oo-eric/guitar-build/output/STAGE_3B.md

=== ADC Test ===
Reading A0 every 500ms: avg | min | max | spread
Stage 1 (nothing): floating random values
Stage 2 (bias only): stable ~2048, spread < 50
Stage 3 (full circuit): ~2048 idle, spread grows on pluck
---
avg: 2043 | min: 2043 | max: 2043 | spread: 0
avg: 2052 | min: 2035 | max: 2069 | spread: 34
avg: 2051 | min: 2033 | max: 2070 | spread: 37
avg: 2051 | min: 2032 | max: 2070 | spread: 38
avg: 2052 | min: 2033 | max: 2071 | spread: 38
avg: 2049 | min: 2030 | max: 2068 | spread: 38
avg: 2052 | min: 2033 | max: 2071 | spread: 38
avg: 2049 | min: 2030 | max: 2068 | spread: 38
avg: 2052 | min: 2034 | max: 2070 | spread: 36
