oo-eric/guitar-build/docs/stompbox/pin_map.md

# Teensy 4.0 pin map — single source of truth

Every pin the stomp box uses. **Check here before assigning anything new** —
this conversation has already produced one collision (pin 1) that would have
been silent until the display and MIDI were tested together.

## Physical layout

Teensy 4.0 has 14 pins per side. USB at the top.

```
              ___USB___
      GND  --|         |--  Vin      <- 5V from the power section
        0  --|         |--  GND
        1  --|  ! ! !  |--  3.3V     -> preamp board
        2  --|         |--  23
        3  --|         |--  22
        4  --|         |--  21
        5  --|         |--  20       <- flanks the analog block, keep clear
        6  --|         |--  19 / A5
        7  --|         |--  18 / A4
        8  --|         |--  17 / A3
        9  --|         |--  16 / A2
       10  --|         |--  15 / A1
       11  --|         |--  14 / A0
       12  --|_________|--  13       <- flanks the analog block. SPI0 SCK
```

**The rule:** analog lives on the right column. Keep switching digital signals
on the left column. Pins **13** and **20** flank the analog block and are the
two most dangerous places to put anything that toggles.

## Assignments

| Pin | Use | Notes |
| ----- | --- | --- |
| 0 | **74HC595 latch (RCLK)**  | Drives all four LED halos. Data/clock share SPI0 |
| **1** | **RESERVED — do not use** | Collision: Serial1 TX _and_ SPI1 MISO. See below |
| 2 | Footswitch — PANIC | Momentary, Bounce2 |
| 3 | Footswitch — MODE | Momentary, Bounce2 |
| 4 | Footswitch — PATCH − | Momentary, Bounce2 |
| 5 | Footswitch — PATCH + | Momentary, Bounce2 |
| 6 | Encoder — switch (click)  | Bounce2, same as the footswitches |
| 7 | Encoder — A | `Encoder.h` |
| 8 | **MIDI OUT TX** | Serial2 TX → 5-pin DIN resistor network |
| 9 | TFT DC | |
| 10 | TFT CS | |
| 11 | TFT MOSI | SPI0 |
| 12 | Encoder — B | `Encoder.h` |
| 13 | TFT SCK | SPI0. **Known noise risk** — see below |
| 14–19 | **A0–A5, preamp inputs**  | Six hex channels from the board's J7 header |
| 20 | **keep clear** | Flanks A5. Nothing that toggles |
| 21 | **Guitar mode — MIDI on** | GK pin 10 (S1). Low = send MIDI. RC-slugged |
| 22 | _spare_ — GK pin 11 (S2)  | Not driven by this guitar. Same RC input circuit |
| 23 | _free_ / A9 | Was the CC pot, dropped 2026-09-18. Analog-capable |
| 3.3V  | → preamp board | Teensy's regulator, 250 mA available, ~0.6 mA used |
| Vin | ← 5V from power section | **Never 9V.** See [`power.md`](power.md) |

## The budget, and the 74HC595

**Relief valve #1 has been spent** (2026-09-02). The guitar gained controls on
the GK control pins — now a Guitar / Mix / MIDI mode switch on pin 10, see
[`../guitar_wiring.md`](../guitar_wiring.md) — and the perimeter was already full, so the four LED halos moved to a
**74HC595** on the existing SPI0 bus.

| | Before | After |
| --- | --- | --- |
| LED halos  | pins 0, 21–23 | 74HC595, latch on pin 0 |
| Pins freed | — | 21, 22, 23 |
| Net change | — | **+3 pins**, all ADC-capable |

The 595's data and clock ride MOSI (11) and SCK (13), already there for the TFT.
Only the latch needs a pin of its own. Pin 0 is Serial1 RX and unused — MIDI OUT
is Serial2 TX on pin 8.

Two things this buys beyond the three pins:

- **Four spare 595 outputs.** The MIDI-activity LED that was cut for lack of a
  pin can come back for free, and so can three more after it.
- SCK only toggles when an LED state changes, which is a stomp, not a loop.

Every perimeter pin is again allocated except pin 1 (reserved), pin 20 (kept
clear) and pin 23, freed when the guitar's CC pot was dropped (2026-09-18). **Relief valve #2** — bottom-side pads 24–33 — is still untouched, and
is still awkward: they are SMT pads under a socketed chip.

### Why switches are allowed on the analog column

Pins 21–23 sit on the right-hand column, which the rule above reserves for
analog. Pin 21 carries the guitar mode switch's closure, and 22 is wired the
same way for S2. That is deliberate and safe here for one specific reason:
**both lines pass through a 10k/100nF RC
at the Teensy pin** — see `../guitar_wiring.md`. A 1 ms time constant means there is physically no fast
edge to couple, which is a stronger guarantee than the "LEDs only change on
state change" argument that previously justified putting halos there.

Pin 23 / A9 is free — the furthest pin from the A0–A5 block, so it is the one
to give any future analog input. Pin 20 stays empty as the buffer next to A5.

## Collision: pin 1

Pin 1 is **Serial1 TX** and **SPI1 MISO** at the same time. Both were candidates:
Serial1 was the obvious choice for MIDI OUT, and SPI1 is the escape route for
the display's noise problem.

Resolved two ways, and both are applied:

- MIDI OUT uses **Serial2 TX (pin 8)** instead. Serial3 and Serial4 land on
  A0–A3 and are unusable; Serial2 (RX 7 / TX 8) is clear of everything
- The **ILI9341 is write-only** — TFT_eSPI runs fine with no MISO defined, so
  SPI1 MISO would not be needed even if SPI1 were used

Pin 1 stays reserved rather than reassigned, so the conflict can't reappear.

## Known risk: SCK on pin 13

SPI0's clock is fixed at pin 13, directly adjacent to pin 14 / A0. On the
breadboard, connecting the TFT drove idle ADC spread from ~55 to 1000–34000.

**Plan A: retest on the PCB before designing around it.** That measurement came
from a breadboard — long unshielded jumpers, no ground plane. The board has
ground pour on both layers and separates the analog section from the digital
header. The picture may change substantially.

**Plan B, only if A fails:** move to SPI1 — MOSI 26, MISO 1, SCK 27 — via
`SPI.setMOSI(26); SPI.setMISO(1); SPI.setSCK(27);` before `tft.init()`. Note
that **26 and 27 are bottom-side SMT pads, not perimeter pins**, so socketing
the Teensy does not expose them; this means soldering fine wires to the
underside of a chip that then sits in a socket. It is the awkward path, which is
why it is Plan B.

Fixes already tried and ruled out on the breadboard: 0.1 µF on A0 (killed the
signal), queue flush after draw, queue stop/start around draw, moving the input
to A4, powering the op-amp buffer.

## Preamp header order

The board's 8-pin Teensy header (J7) is **not** in A0–A5 order. Physical order
is `GND, +3V3, A1, A0, A3, A2, A5, A4` — chosen so the six ADC runs fan into the
connector without crossing. **Wire it from the silkscreen labels, not from
memory.**
