oo-eric/guitar-build/body/iceman.png

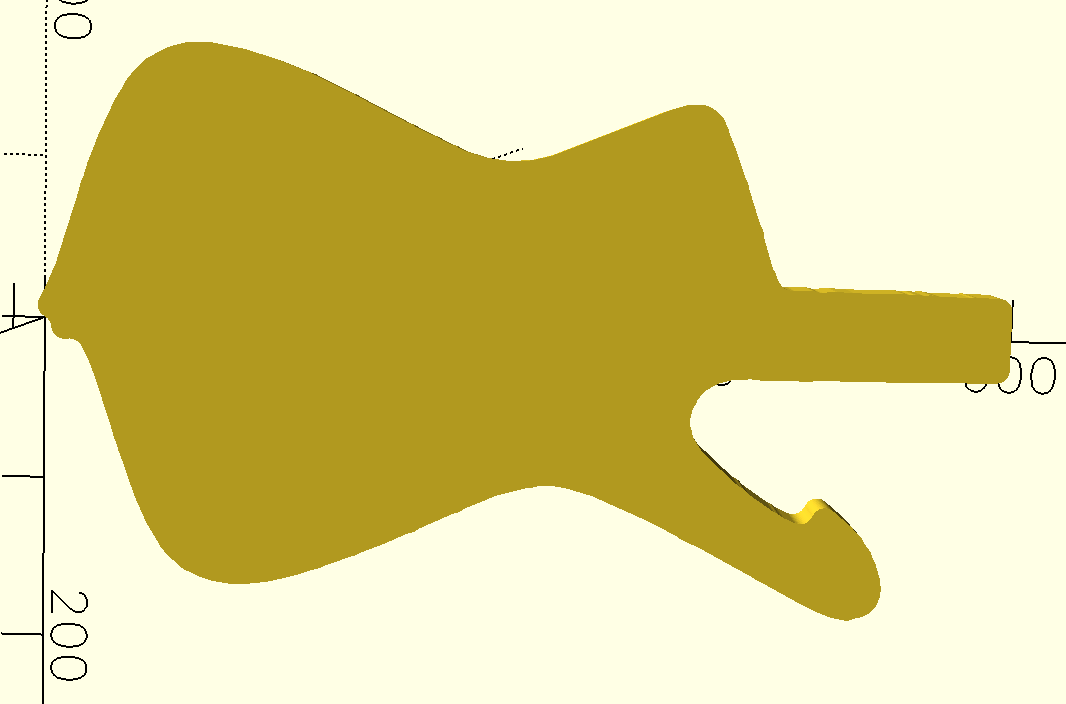
body/iceman.png
