oo-eric/guitar-build/body/iceman.scad

// Ibanez Iceman - outline traced from a product photo.
// Body + (cropped) neck as one silhouette. Reference geometry only:
// the photo had no ruler, so scale rests on ONE assumption below.

body_width = 340.0;   // mm, widest point of the lower bout <-- measure & correct
thickness  = 45;    // mm, korina blank thickness <-- measure & correct

soften = 8;         // mm corner radius - 0 = raw Iceman trace, higher = Jazzmaster
$fn = 64;           // segments on the offset arcs; raise for export

// Round convex AND concave corners at radius r, keeping overall size.
// Reads inside-out: erode r, dilate 2r, erode r
//   = opening (rounds the outside corners) then closing (rounds the inside ones).
module soften_corners(r) {
  if (r <= 0) children();
  else offset(r = -r) offset(r = 2 * r) offset(r = -r) children();
}

// Origin: X centred on the body, Y = 0 at the bottom tip.
module iceman_outline() {
  polygon(points = [
    [-6.21, 0.0], [-8.58, 0.0], [-10.65, 2.96], [-20.42, 7.99],
    [-35.51, 14.5], [-75.75, 26.93], [-83.15, 29.0], [-84.33, 28.7],
    [-87.0, 30.48], [-97.06, 33.44], [-113.93, 39.95], [-134.64, 49.42],
    [-142.92, 54.45], [-144.7, 54.74], [-149.14, 58.59], [-150.91, 58.59],
    [-151.36, 60.22], [-159.35, 67.91], [-166.45, 81.23], [-170.0, 93.36],
    [-169.41, 96.02], [-169.7, 107.27], [-166.45, 126.21], [-161.12, 145.14],
    [-154.32, 163.19], [-154.32, 165.27], [-152.25, 167.93], [-142.48, 189.23],
    [-141.89, 192.19], [-140.41, 193.67], [-128.87, 217.05], [-124.73, 225.63],
    [-124.73, 227.7], [-122.65, 229.77], [-117.92, 239.83], [-117.92, 242.79],
    [-115.85, 244.57], [-112.59, 251.67], [-112.3, 254.33], [-110.82, 255.81],
    [-109.04, 259.66], [-105.2, 272.98], [-103.72, 285.4], [-104.6, 299.02],
    [-107.56, 311.15], [-136.56, 381.28], [-140.41, 393.41], [-140.11, 403.47],
    [-138.63, 406.73], [-135.38, 411.17], [-132.27, 414.27], [-128.42, 415.46],
    [-126.95, 417.23], [-124.28, 417.23], [-112.15, 422.56], [-96.76, 428.18],
    [-94.69, 430.55], [-93.21, 429.96], [-91.44, 430.25], [-69.24, 437.95],
    [-65.99, 440.02], [-62.14, 440.31], [-44.09, 446.23], [-42.61, 446.82],
    [-40.84, 449.19], [-37.88, 448.89], [-31.22, 453.19], [-30.33, 459.99],
    [-30.63, 473.01], [-29.74, 474.79], [-30.63, 485.44], [-30.03, 496.09],
    [-30.33, 526.87], [-29.74, 528.94], [-30.33, 532.19], [-29.74, 537.52],
    [-30.03, 543.14], [-29.15, 547.58], [-29.15, 565.93], [-29.74, 568.59],
    [-29.15, 570.07], [-28.85, 591.67], [22.19, 591.82], [22.64, 568.59],
    [23.23, 567.11], [22.64, 565.63], [22.64, 547.28], [23.23, 545.21],
    [23.52, 479.52], [24.12, 469.46], [24.12, 438.09], [23.23, 434.84],
    [24.41, 432.18], [23.82, 430.1], [24.12, 425.37], [26.48, 416.49],
    [30.63, 409.09], [32.85, 406.88], [34.33, 406.58], [34.47, 405.54],
    [37.28, 403.32], [39.95, 403.62], [40.1, 402.58], [42.02, 400.96],
    [48.83, 399.48], [53.86, 399.77], [55.34, 401.85], [57.11, 400.96],
    [59.77, 401.55], [68.65, 407.47], [87.15, 428.03], [89.22, 430.7],
    [89.22, 432.47], [93.36, 436.02], [103.72, 451.41], [104.6, 452.89],
    [104.6, 454.96], [106.68, 456.44], [107.86, 458.51], [112.0, 468.28],
    [111.11, 471.53], [108.6, 474.34], [106.53, 475.82], [98.54, 478.49],
    [98.39, 481.3], [102.83, 488.4], [111.71, 499.05], [112.0, 500.83],
    [113.93, 501.27], [117.92, 505.27], [118.07, 506.3], [122.21, 508.08],
    [127.54, 512.22], [131.68, 513.7], [133.16, 515.77], [134.93, 515.47],
    [143.81, 518.43], [150.62, 519.32], [155.65, 518.73], [161.27, 516.36],
    [165.27, 512.66], [168.22, 507.63], [167.93, 506.15], [170.0, 500.53],
    [170.0, 497.57], [168.52, 489.58], [165.56, 481.3], [162.01, 473.31],
    [146.62, 444.01], [146.62, 442.53], [144.85, 440.76], [127.39, 407.32],
    [122.65, 396.37], [119.99, 392.52], [110.52, 372.7], [97.21, 341.04],
    [92.77, 324.76], [91.88, 317.66], [91.88, 309.67], [92.77, 305.82],
    [93.66, 304.93], [93.36, 301.38], [98.39, 283.63], [106.68, 264.69],
    [109.93, 259.66], [109.93, 257.89], [120.29, 235.99], [122.95, 233.03],
    [122.95, 230.07], [129.76, 215.87], [135.97, 200.77], [138.04, 198.11],
    [138.04, 196.04], [144.85, 178.29], [146.92, 176.81], [146.33, 175.33],
    [146.62, 173.55], [149.29, 165.56], [150.77, 163.79], [150.47, 162.01],
    [151.95, 156.98], [152.84, 156.09], [152.54, 154.91], [155.2, 144.26],
    [156.68, 132.72], [156.98, 122.36], [155.5, 111.71], [153.43, 104.31],
    [149.88, 96.61], [149.88, 94.84], [139.52, 83.0], [139.52, 82.11],
    [137.01, 81.08], [134.34, 78.12], [132.86, 78.12], [120.14, 70.43],
    [104.46, 63.32], [78.71, 54.15], [77.23, 52.67], [75.46, 52.97],
    [71.02, 51.49], [69.54, 50.01], [66.58, 50.01], [33.44, 39.06],
    [21.9, 34.62], [13.61, 30.48], [8.73, 26.48], [8.73, 24.12],
    [10.8, 21.45], [9.03, 13.46], [4.73, 10.65], [2.66, 10.65],
    [1.18, 12.13], [-1.18, 12.13], [-2.52, 10.8], [-6.21, 0.0]
  ]);
}

linear_extrude(height = thickness)
  soften_corners(soften)
    iceman_outline();
