oo-eric/guitar-build/body/test_box.scad

// throwaway test — units are mm
cube([24, 24, 2]);
