oo-eric/guitar-build/hardware/midi-guitar-preamp.pdf

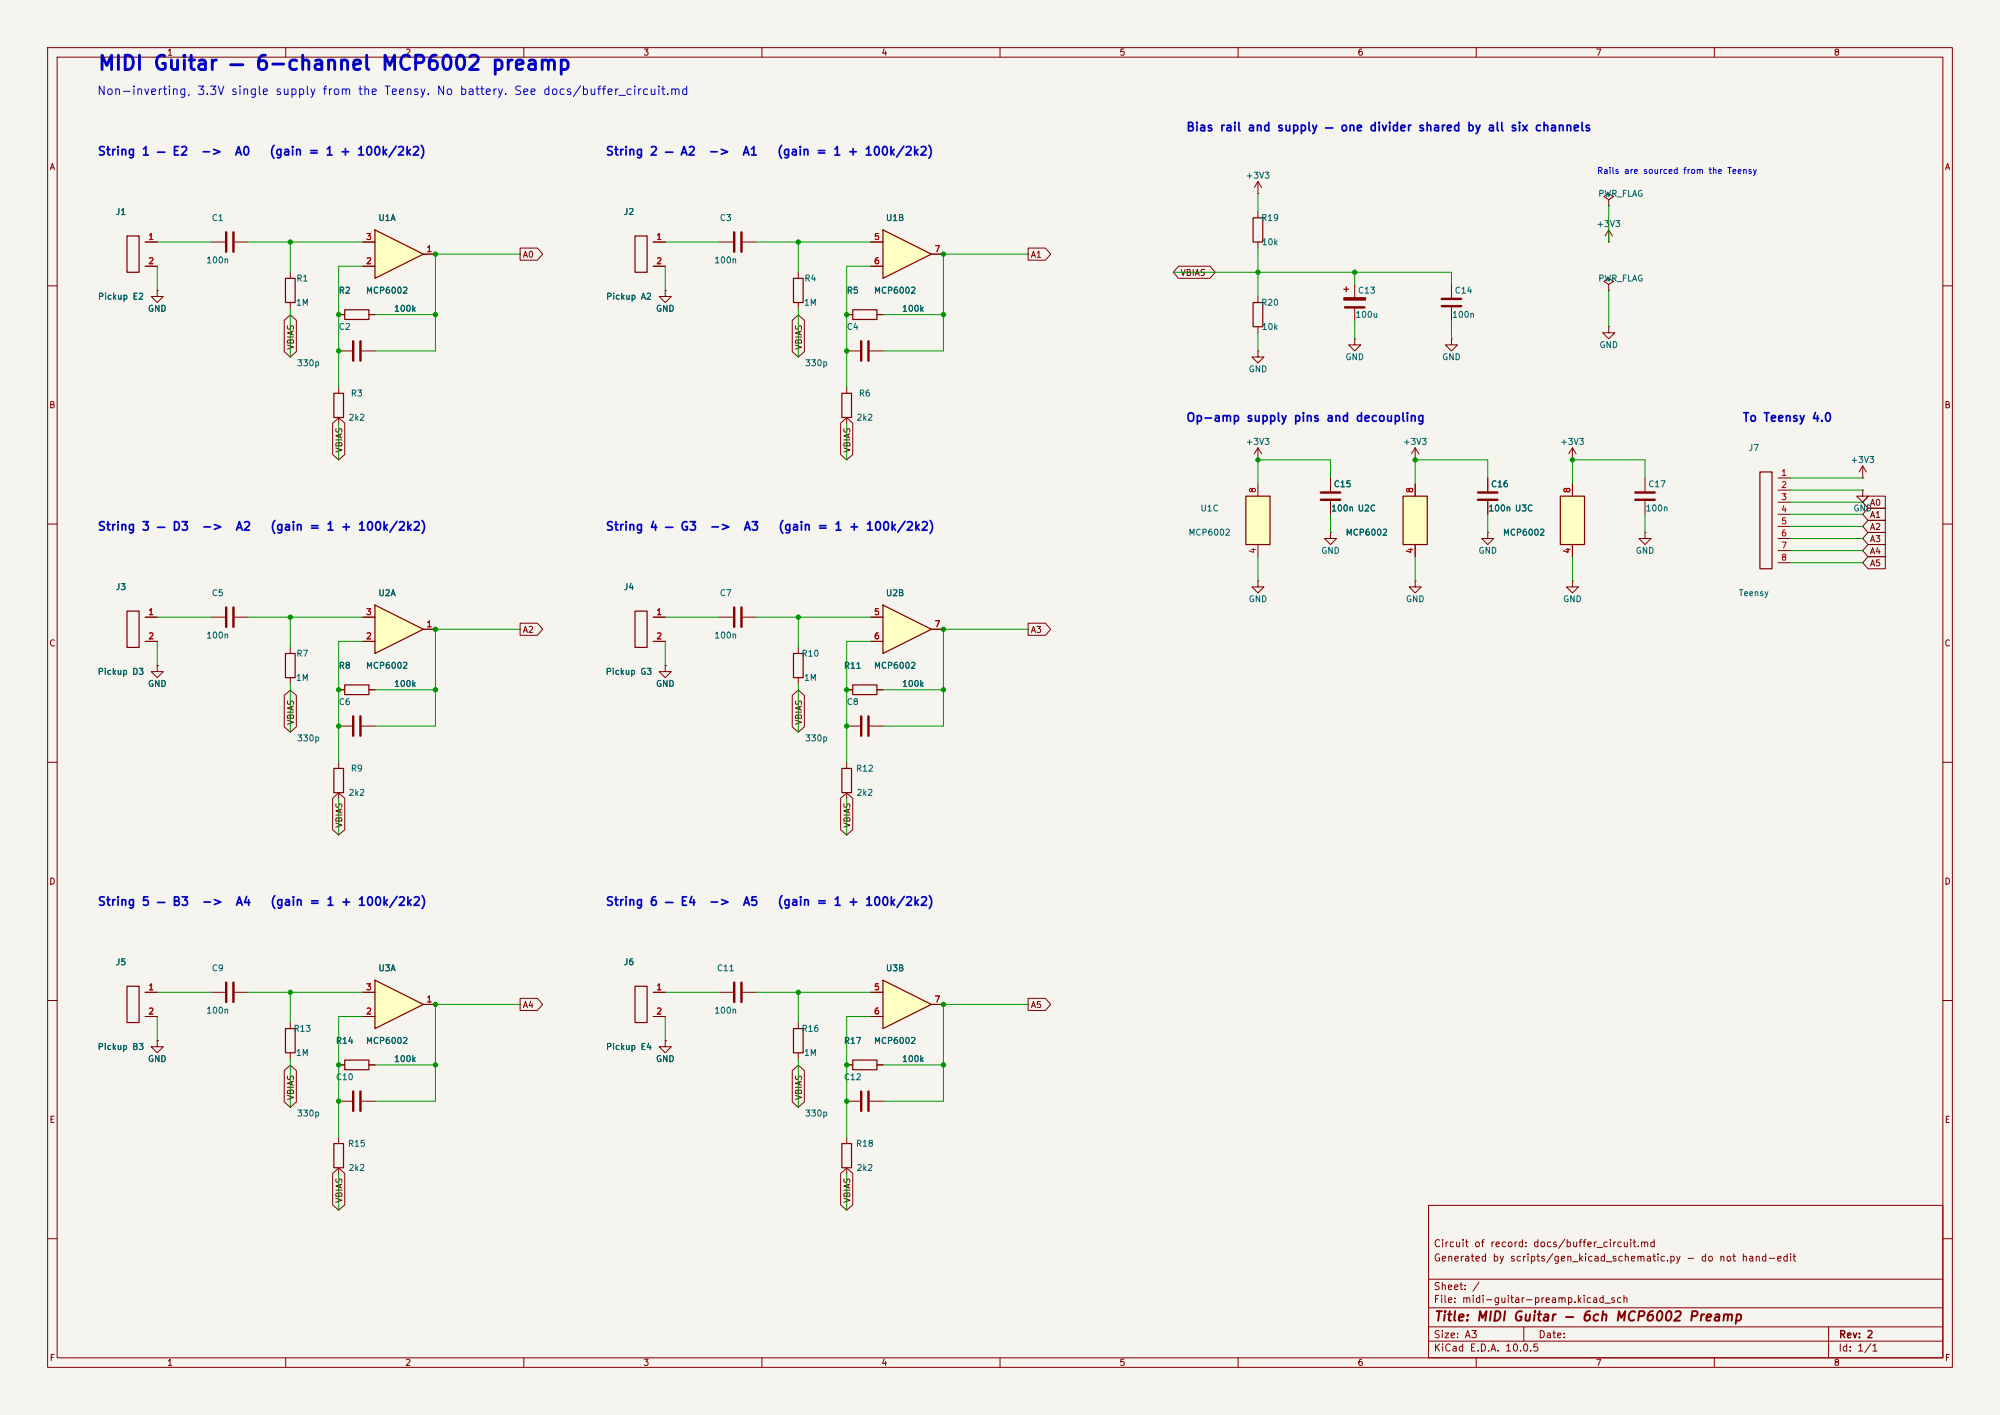
[picture p2: page 1]

MIDI Guitar — 6-channel MCP6002 preamp

Non-inverting, 3.3V single supply from the Teensy. No battery. See docs/buffer_circuit.md

Bias rail and supply — one divider shared by all six channels

Rails are sourced from the Teensy

Op-amp supply pins and decoupling

Circuit of record: docs/buffer_circuit.md
Generated by scripts/gen_kicad_schematic.py - do not hand-edit

Sheet: /
File: midi-guitar-preamp.kicad_sch
Title: MIDI Guitar - 6ch MCP6002 Preamp

Size: A3 | Rev: 2 | F Date:
KiCad E.D.A. 10.0.5 | Id: 1/1
