oo-eric/guitar-build/body/iceman_template.pdf

## ICEMAN BODY TEMPLATE - assembly map

339.7 x 587.9 mm outline | soften r=8.0 mm | 3 x 2 sheets, 15 mm overlap

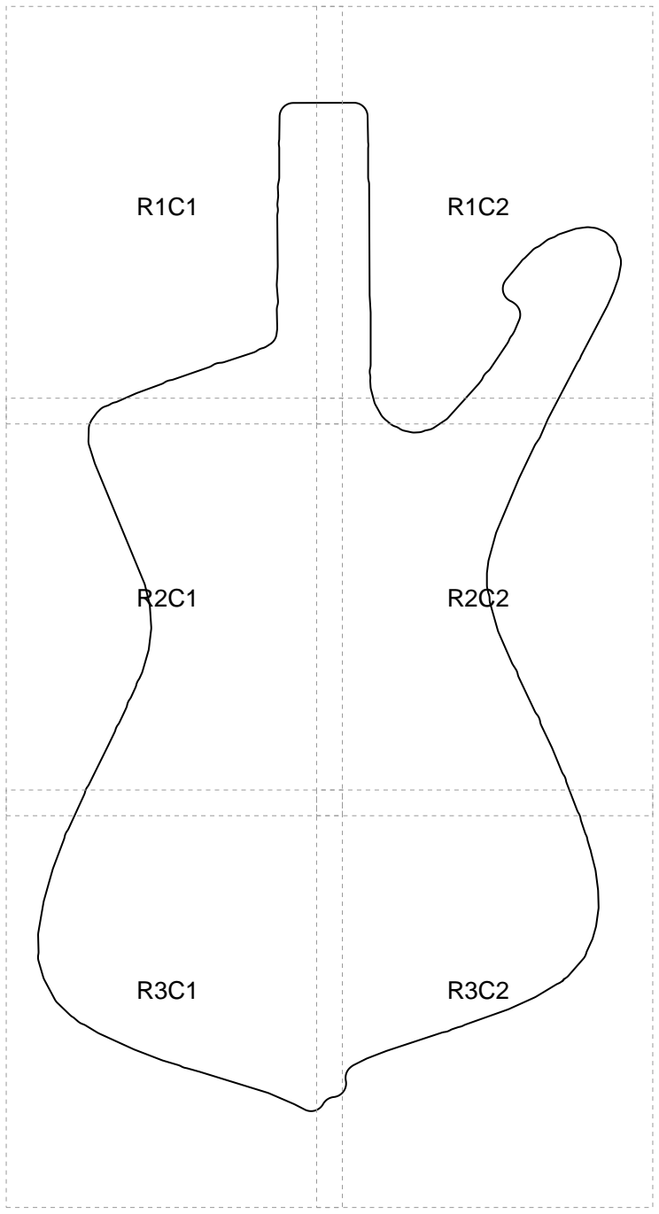
[picture p3: figure]

5. The dash-dot line is the body centreline. It must be dead straight across the whole assembly - that is your check.
4. Lay sheets out per this map. Slide until the + crosses in the overlap sit exactly on top of each other, then tape.
3. Trim each sheet along the dashed line on its RIGHT and BOTTOM edges only.
2. Check the 100 mm ruler in every footer with a steel rule. If it is off, the print is off - fix it, do not compensate.
1. Print at 100% / Actual Size. Turn OFF 'fit to page' and 'shrink oversized pages'.

100 mm reference - measure before cutting

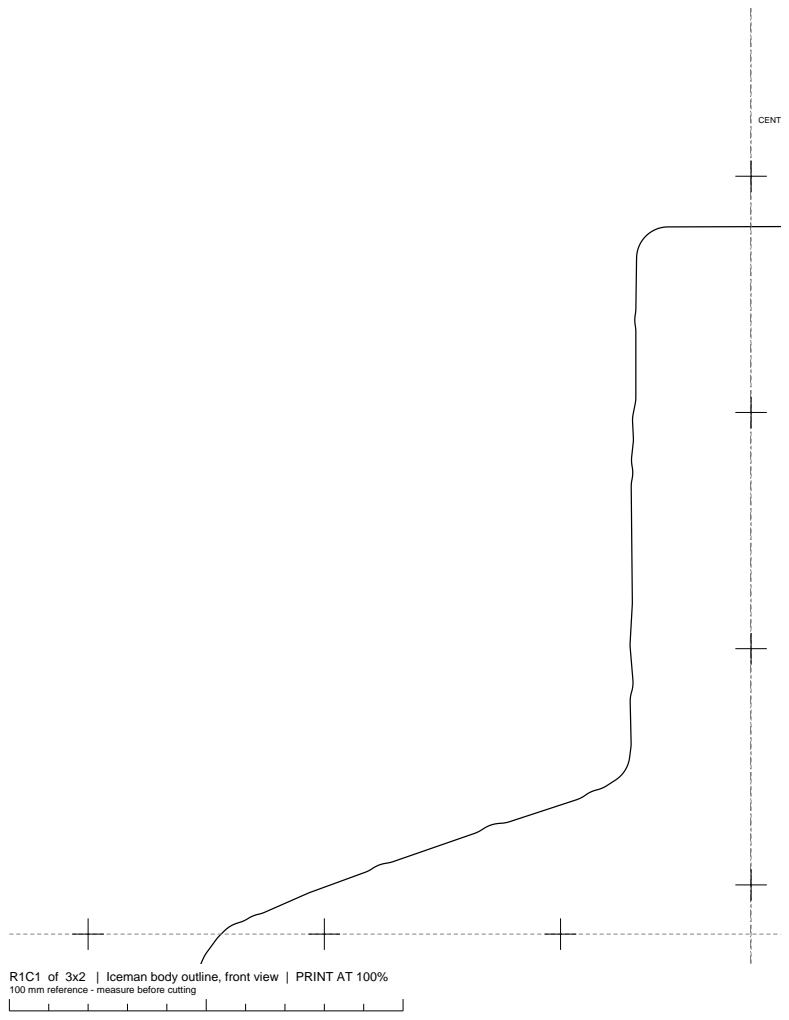
[picture p4: page 2]
CENTRELINE

R1C1 of 3x2 | Iceman body outline, front view | PRINT AT 100%

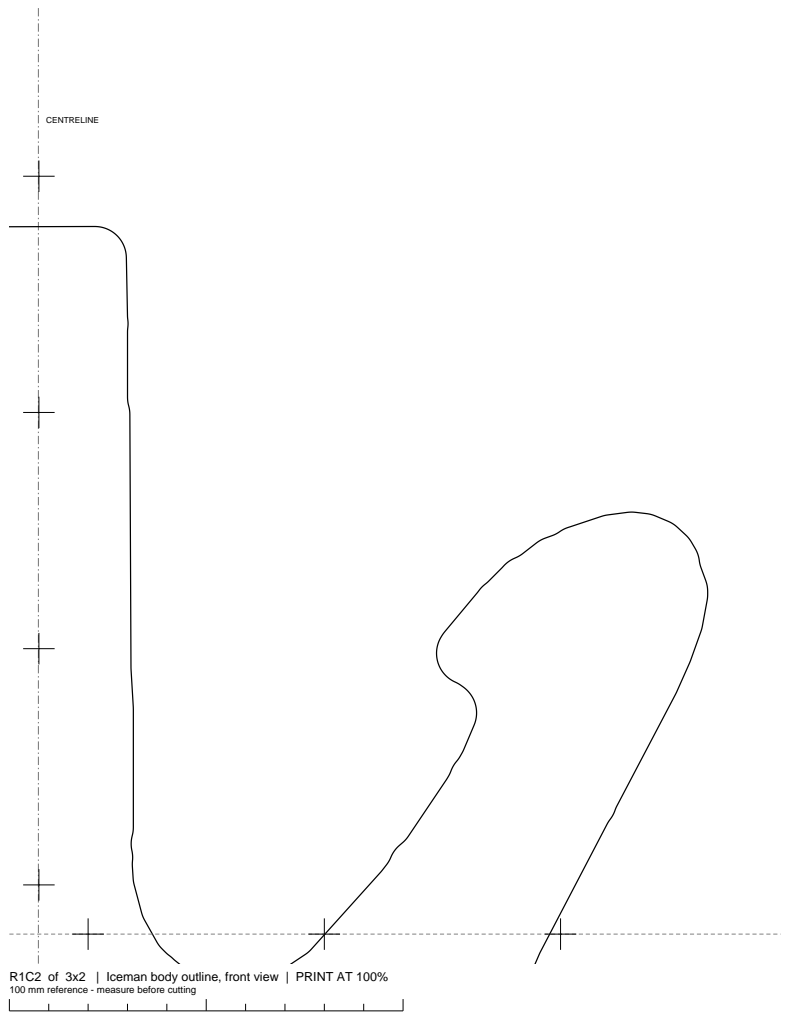
[picture p5: page 3]
CENTRELINE

R1C2 of 3x2 | Iceman body outline, front view | PRINT AT 100%

CENTRELINE

R2C1 of 3x2 | Iceman body outline, front view | PRINT AT 100%

CENTRELINE

R2C2 of 3x2 | Iceman body outline, front view | PRINT AT 100%

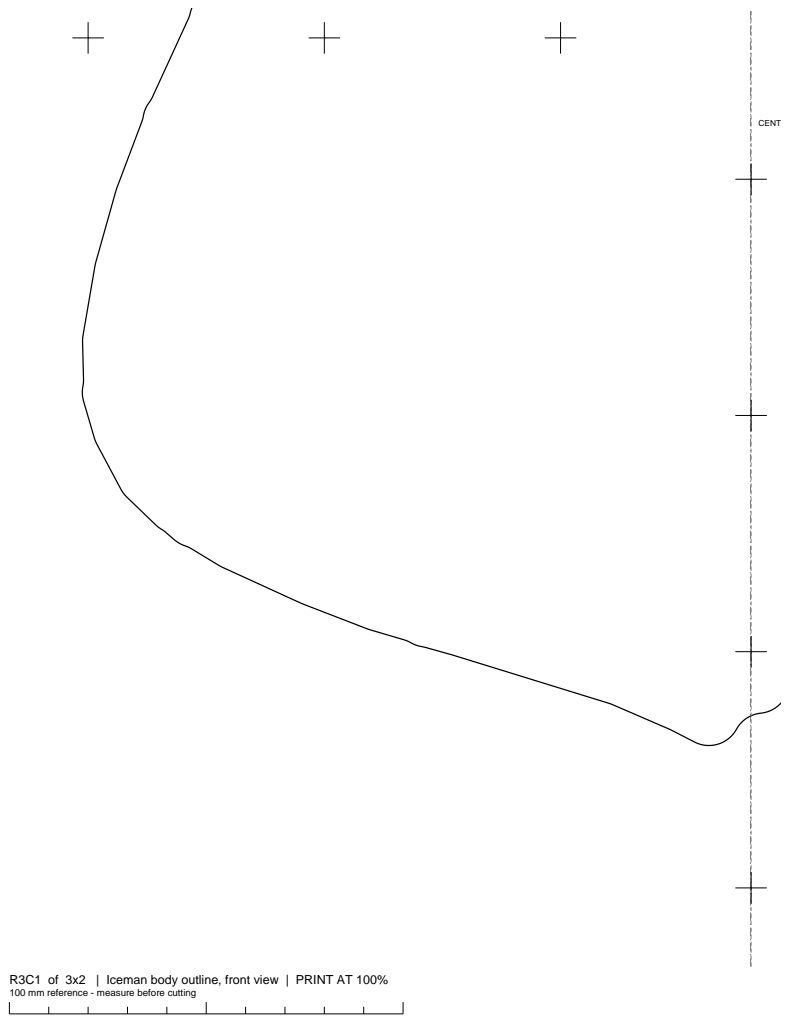
[picture p6: page 6]
CENTRELINE

R3C1 of 3x2 | Iceman body outline, front view | PRINT AT 100%

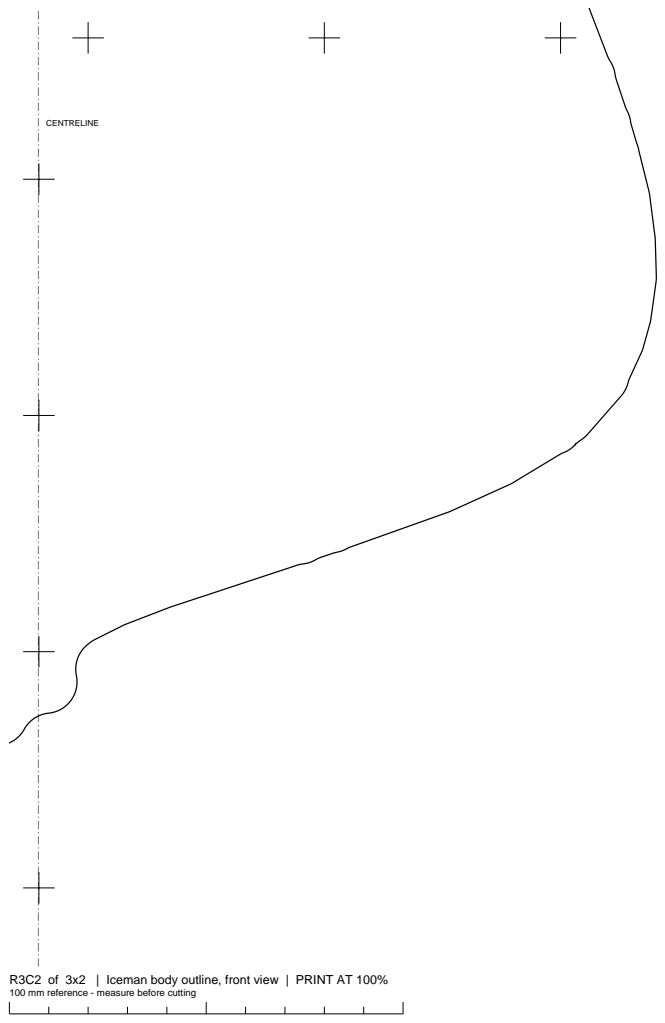
[picture p7: page 7]
CENTRELINE

R3C2 of 3x2 | Iceman body outline, front view | PRINT AT 100%
