oo-eric/guitar-build/hardware/pcb-bottom.pdf

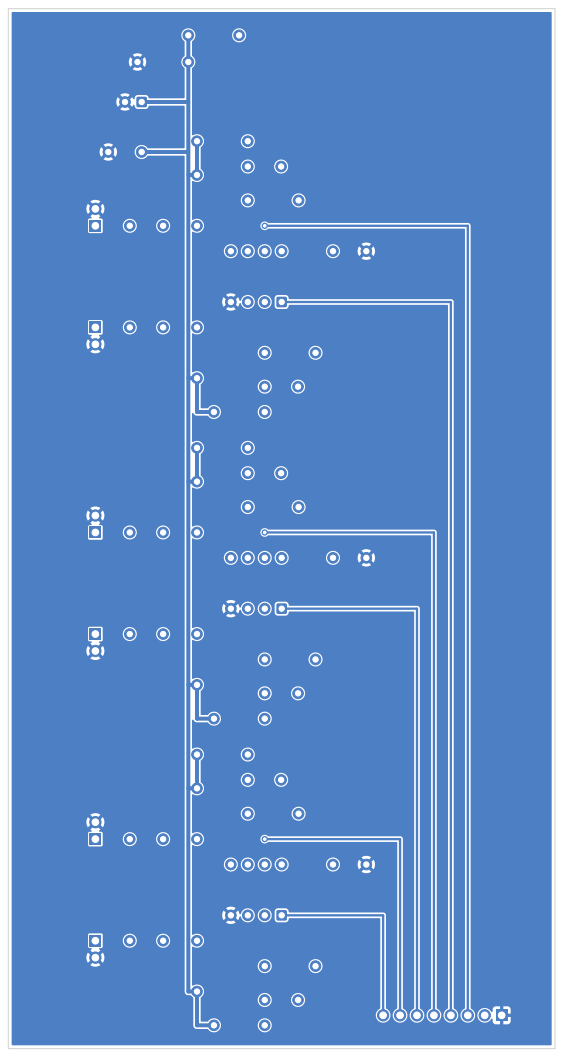
[picture p8: page 1]
