oo-eric/guitar-build/hardware/pcb-top.pdf

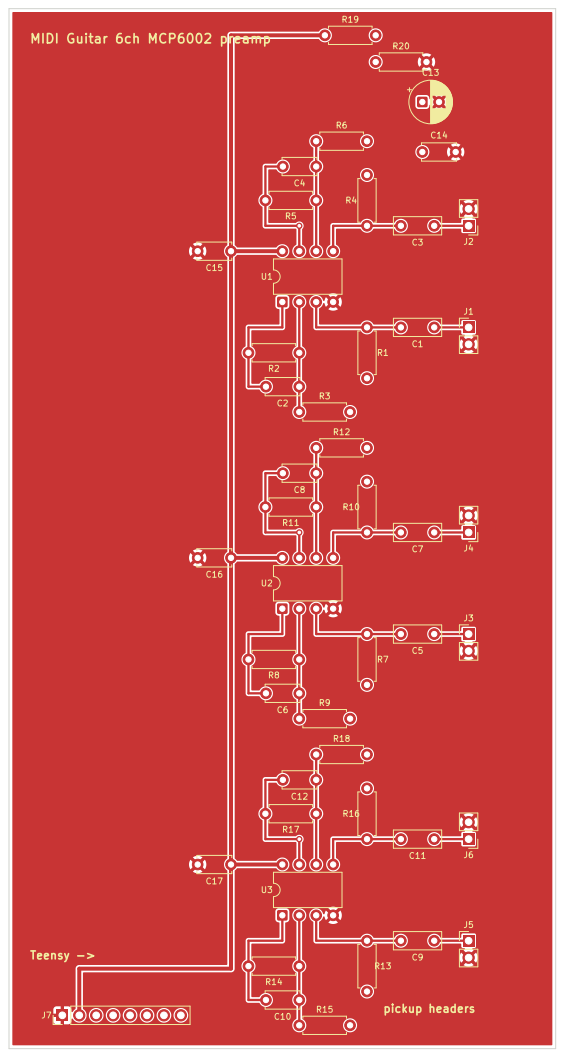
[picture p9: page 1]
