oo-eric/guitar-build/hardware/midi-guitar-preamp.kicad_pcb

## KiCad design hardware/midi-guitar-preamp.kicad_pcb (2026-08-09)

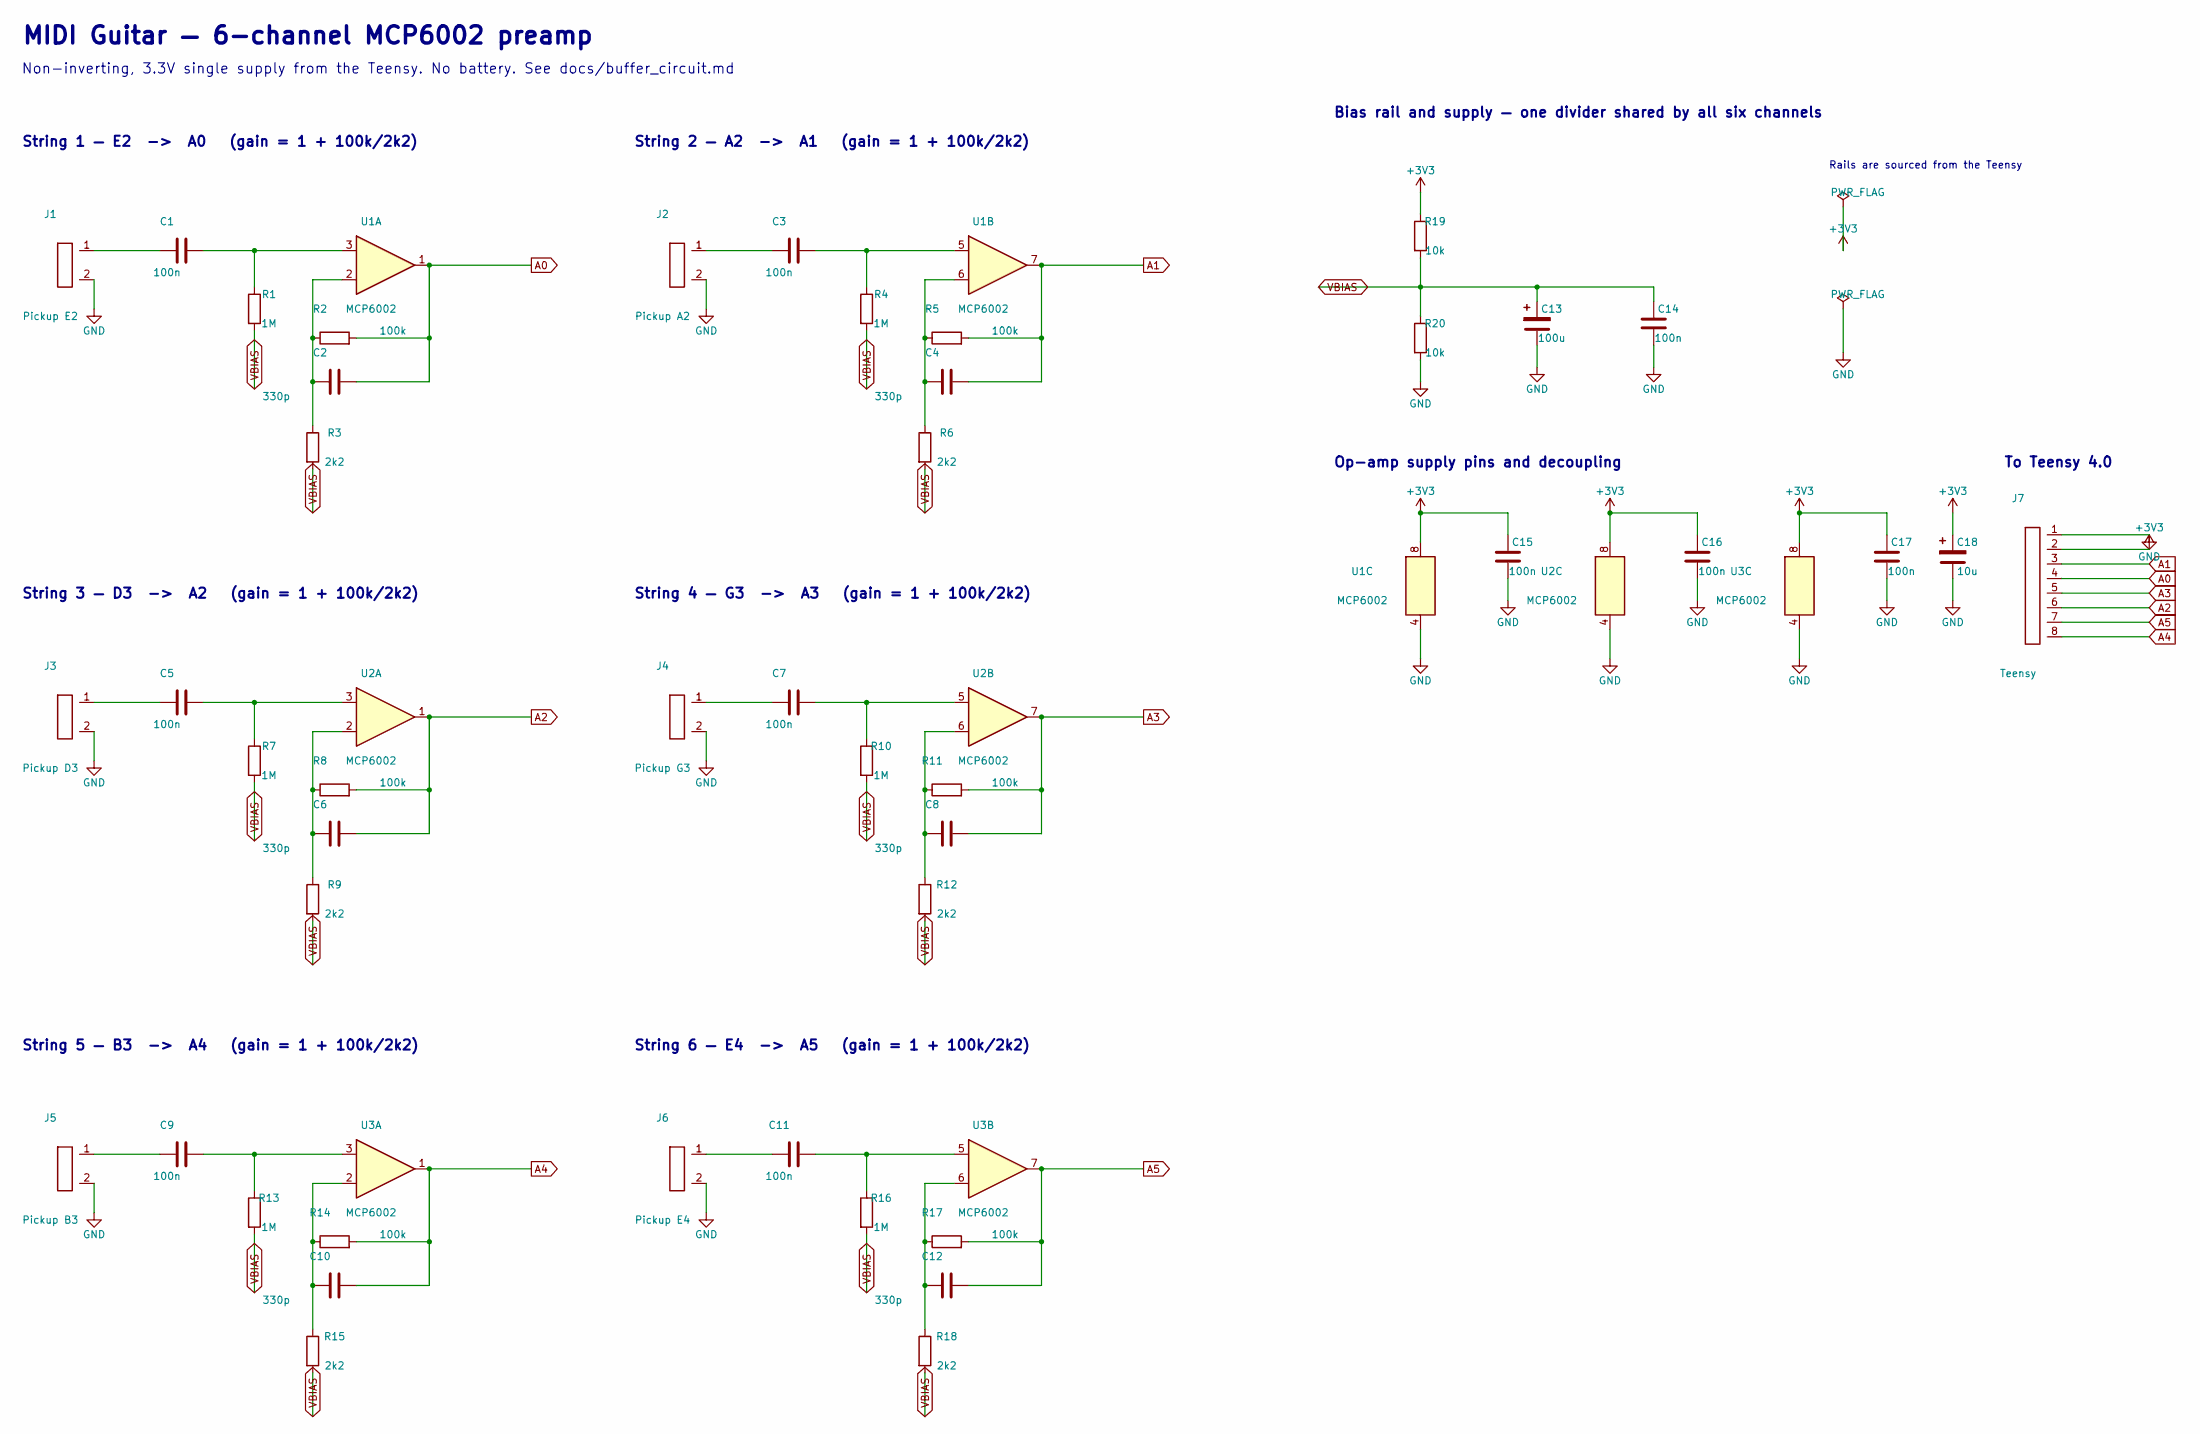
[picture p10: schematic midi-guitar-preamp.kicad_sch, MIDI Guitar - 6ch MCP6002 Preamp]

Parts:
C1, C3, C5, C7, C9, C11: 100n; C_Rect_L7.0mm_W2.5mm_P5.00mm
C2, C4, C6, C8, C10, C12: 330p; C_Disc_D5.0mm_W2.5mm_P5.00mm
C13: 100u; CP_Radial_D6.3mm_P2.50mm
C14, C15, C16, C17: 100n; C_Disc_D5.0mm_W2.5mm_P5.00mm
C18: 10u; CP_Radial_D6.3mm_P2.50mm
J1: Pickup E2; PinHeader_1x02_P2.54mm_Vertical
J2: Pickup A2; PinHeader_1x02_P2.54mm_Vertical
J3: Pickup D3; PinHeader_1x02_P2.54mm_Vertical
J4: Pickup G3; PinHeader_1x02_P2.54mm_Vertical
J5: Pickup B3; PinHeader_1x02_P2.54mm_Vertical
J6: Pickup E4; PinHeader_1x02_P2.54mm_Vertical
J7: Teensy; PinHeader_1x08_P2.54mm_Vertical
R1, R4, R7, R10, R13, R16: 1M; R_Axial_DIN0207_L6.3mm_D2.5mm_P7.62mm_Horizontal
R2, R5, R8, R11, R14, R17: 100k; R_Axial_DIN0207_L6.3mm_D2.5mm_P7.62mm_Horizontal
R3, R6, R9, R12, R15, R18: 2k2; R_Axial_DIN0207_L6.3mm_D2.5mm_P7.62mm_Horizontal
R19, R20: 10k; R_Axial_DIN0207_L6.3mm_D2.5mm_P7.62mm_Horizontal
U1, U2, U3: MCP6002; DIP-8_W7.62mm

Connections:
+3V3: C15.1, C16.1, C17.1, C18.1, J7.2, R19.1, U1.8 (VDD), U2.8 (VDD), U3.8 (VDD)
A0: C2.2, J7.4, R2.2, U1.1
A1: C4.2, J7.3, R5.2, U1.7
A2: C6.2, J7.6, R8.2, U2.1
A3: C8.2, J7.5, R11.2, U2.7
A4: C10.2, J7.8, R14.2, U3.1
A5: C12.2, J7.7, R17.2, U3.7
GND: C13.2, C14.2, C15.2, C16.2, C17.2, C18.2, J1.2, J2.2, J3.2, J4.2, J5.2, J6.2, J7.1, R20.2, U1.4 (VSS), U2.4 (VSS), U3.4 (VSS)
unnamed: C1.1, J1.1
unnamed: C3.1, J2.1
unnamed: C5.1, J3.1
unnamed: C7.1, J4.1
unnamed: C9.1, J5.1
unnamed: C11.1, J6.1
unnamed: C1.2, R1.1, U1.3 (+)
unnamed: C2.1, R2.1, R3.1, U1.2 (-)
unnamed: C3.2, R4.1, U1.5 (+)
unnamed: C4.1, R5.1, R6.1, U1.6 (-)
unnamed: C5.2, R7.1, U2.3 (+)
unnamed: C6.1, R8.1, R9.1, U2.2 (-)
unnamed: C7.2, R10.1, U2.5 (+)
unnamed: C8.1, R11.1, R12.1, U2.6 (-)
unnamed: C9.2, R13.1, U3.3 (+)
unnamed: C10.1, R14.1, R15.1, U3.2 (-)
unnamed: C11.2, R16.1, U3.5 (+)
unnamed: C12.1, R17.1, R18.1, U3.6 (-)
VBIAS: C13.1, C14.1, R1.2, R3.2, R4.2, R6.2, R7.2, R9.2, R10.2, R12.2, R13.2, R15.2, R16.2, R18.2, R19.2, R20.1

Notes on the sheet:
MIDI Guitar — 6-channel MCP6002 preamp
Non-inverting, 3.3V single supply from the Teensy. No battery. See docs/buffer_circuit.md
String 1 — E2 -> A0 (gain = 1 + 100k/2k2)
String 2 — A2 -> A1 (gain = 1 + 100k/2k2)
String 3 — D3 -> A2 (gain = 1 + 100k/2k2)
String 4 — G3 -> A3 (gain = 1 + 100k/2k2)
String 5 — B3 -> A4 (gain = 1 + 100k/2k2)
String 6 — E4 -> A5 (gain = 1 + 100k/2k2)
Bias rail and supply — one divider shared by all six channels
Op-amp supply pins and decoupling
Rails are sourced from the Teensy
To Teensy 4.0

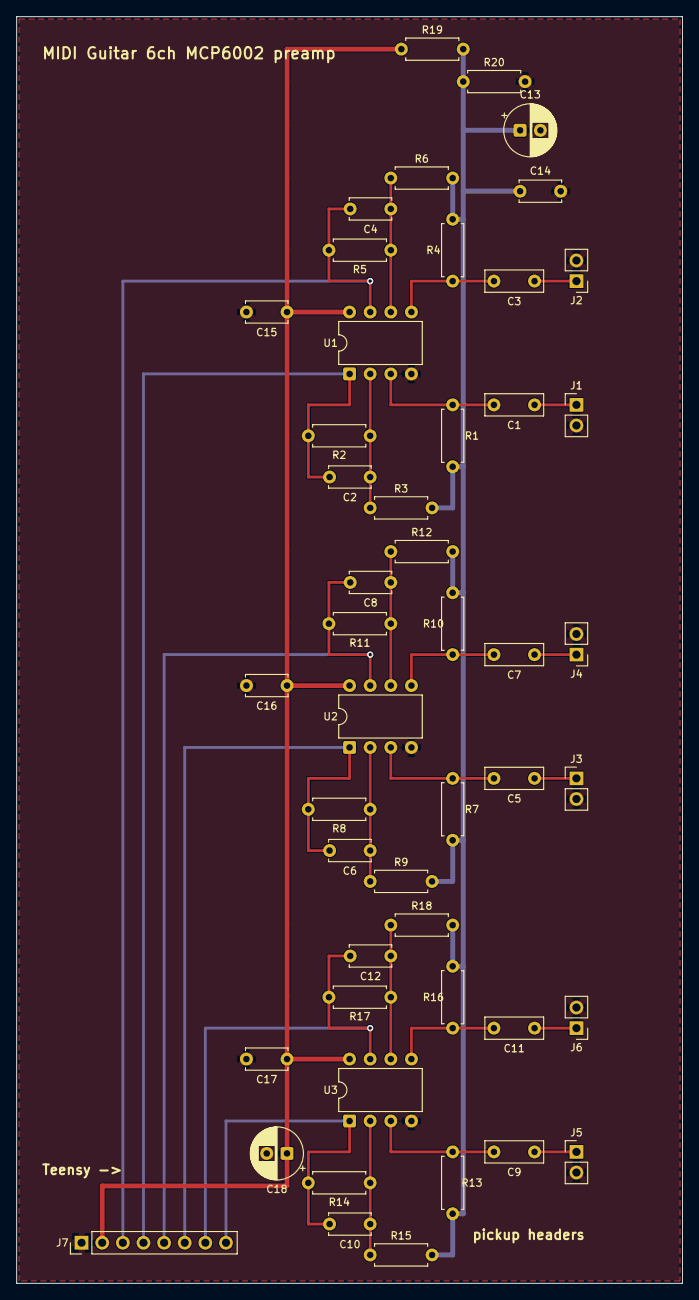
[picture p11: board midi-guitar-preamp.kicad_pcb from above]

Board: 2 copper layers, 82.0 x 156.0 mm, 48 parts (0 on the bottom side), 27 nets.
