oo-eric/guitar-build/(commit log)

2026-02-28 add schematic
2026-03-13 teensy 4.0
2026-03-15 refine pitch jumps, signal thresholds
2026-05-07 no 9v battery
2026-08-09 kicad scripts
2026-08-09 stompbox, update board
    [midi-guitar-preamp.kicad_pcb, midi-guitar-preamp.kicad_sch]
2026-09-02 update wiring
2026-09-19 wiring, standardize agents
2026-11-07 body/head shapes
    [headstock.scad]
2026-11-07 wiring updates
2026-11-07 current parts list
2026-11-07 Add HexScope diagnostics app and firmware telemetry
    iOS can't open the Teensy's USB serial port, so the firmware now sends
    per-string diagnostics as USB MIDI SysEx (telemetry.h/.cpp) alongside the
    existing serial debug. HexScope (SwiftUI, iPhone/iPad/Mac) decodes it over
    CoreMIDI: live per-string level, bias, swing, pitch, scope and wiring
    warnings, plus recorded captures that can be compared.
    Firmware: NUM_STRINGS 2 -> 6, STRING_NAMES reordered so index 0 is high E.
    Claude-Session: https://claude.ai/code/session_01AJosYq2B7RVqhgRcLxj5Cz
